je1rav/QP-7C_RP2040/images/QP-7C_RP2040_super_diagram.pdf

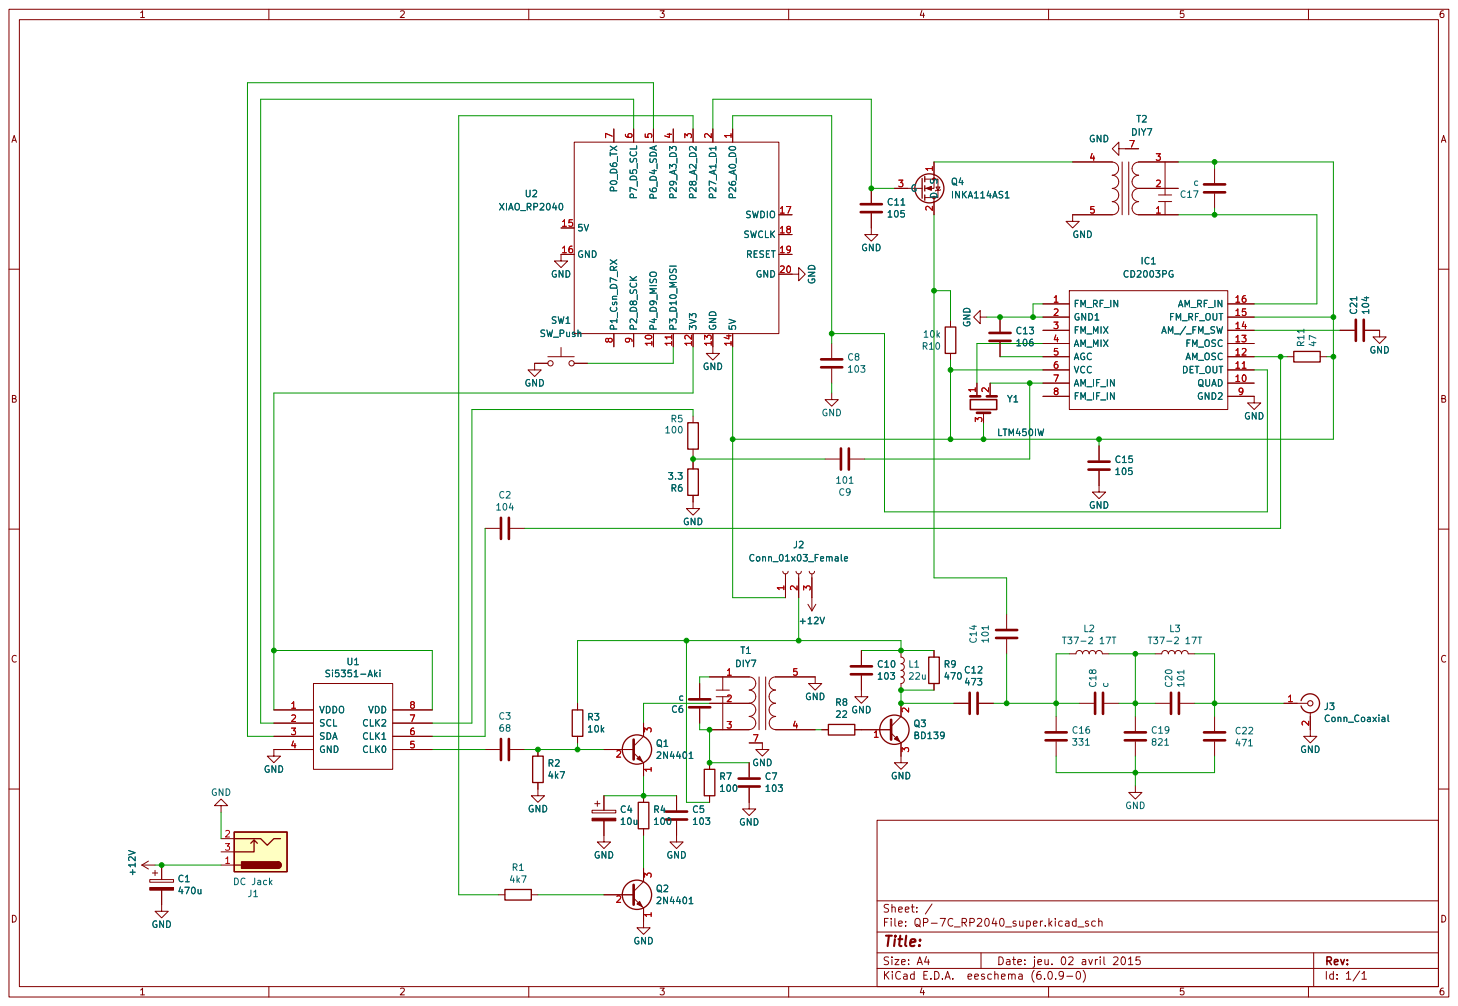
[picture p7: page 1]

File: QP-7C_RP2040_super.kicad_sch Sheet: / GND
