je1rav/QP-7C_RP2040/images/QP-7C_RP2040_diagram.pdf

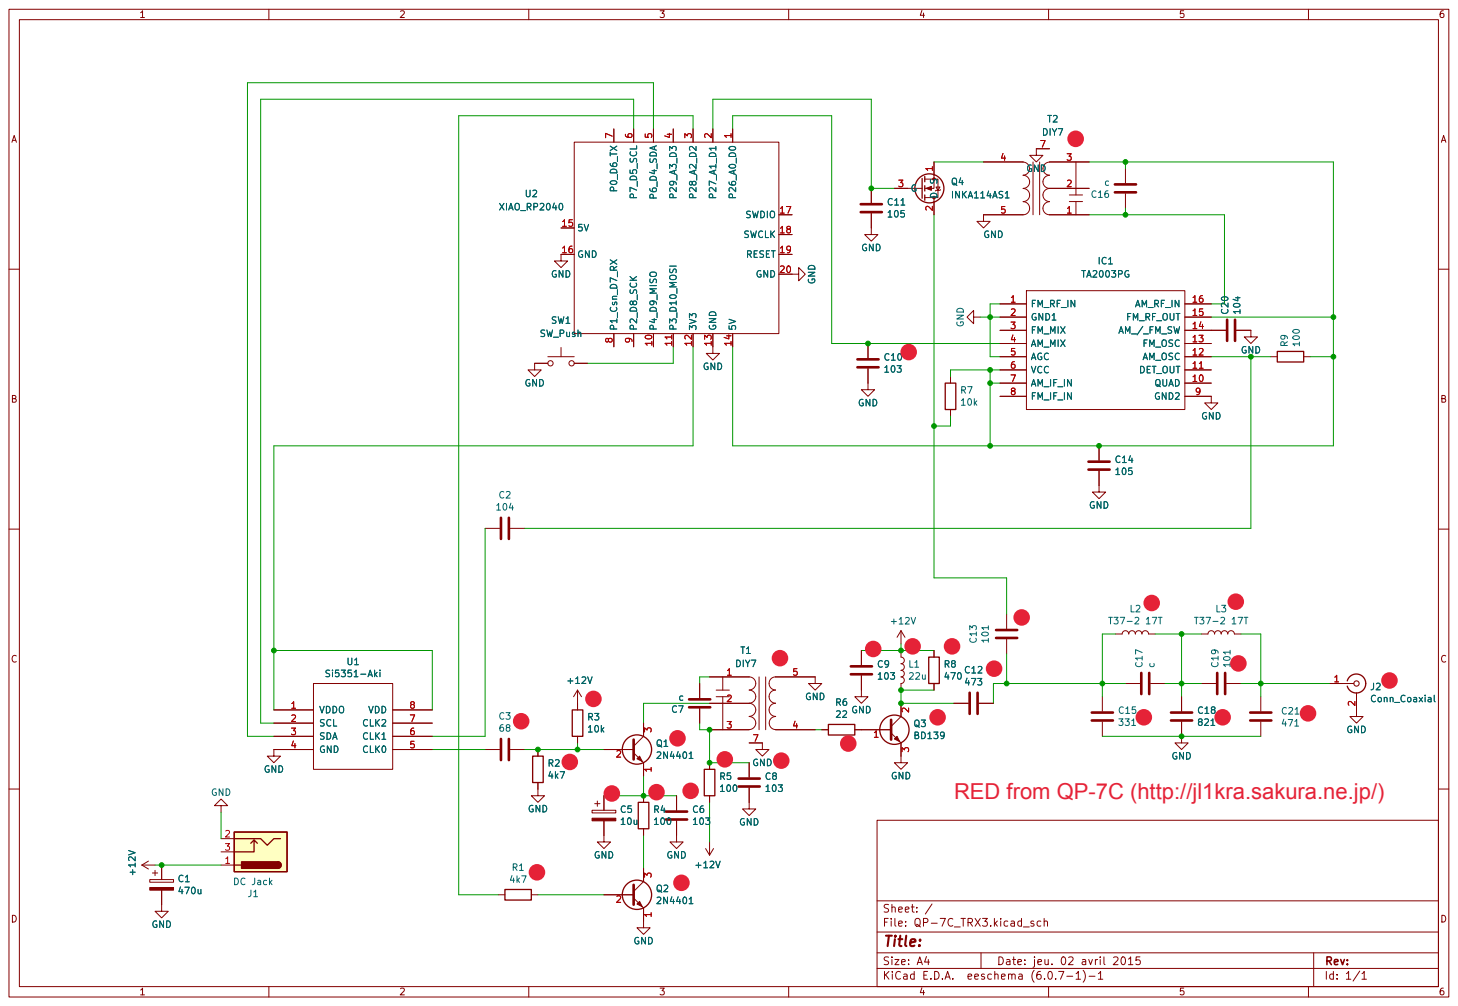
[picture p8: page 1]

9 U2 XIAO_RP2040 GND
105 GND GND GND GND

RED from QP-7C (http://jl1kra.sakura.ne.jp/)
