je1rav/QP-7C_RP2040/(notices)

Notices in the files:
QP-7C_RP2040_super.ino:
QP-7C_RP2040.ino is free software: you can redistribute it and/or modify
it under the terms of the GNU General Public License as published by
the Free Software Foundation, either version 3 of the License, or
any later version.
